Brandon-Valley/BLDC-PCB/BLDC_BOM_mouser.csv

Qty1 | Mfr Part No.
2 | WSLP27261L000FEA
1 | STM32F405RGT6
