Brandon-Valley/BLDC-PCB/BLDC.brd

## EAGLE design BLDC.brd (2017-07-13)

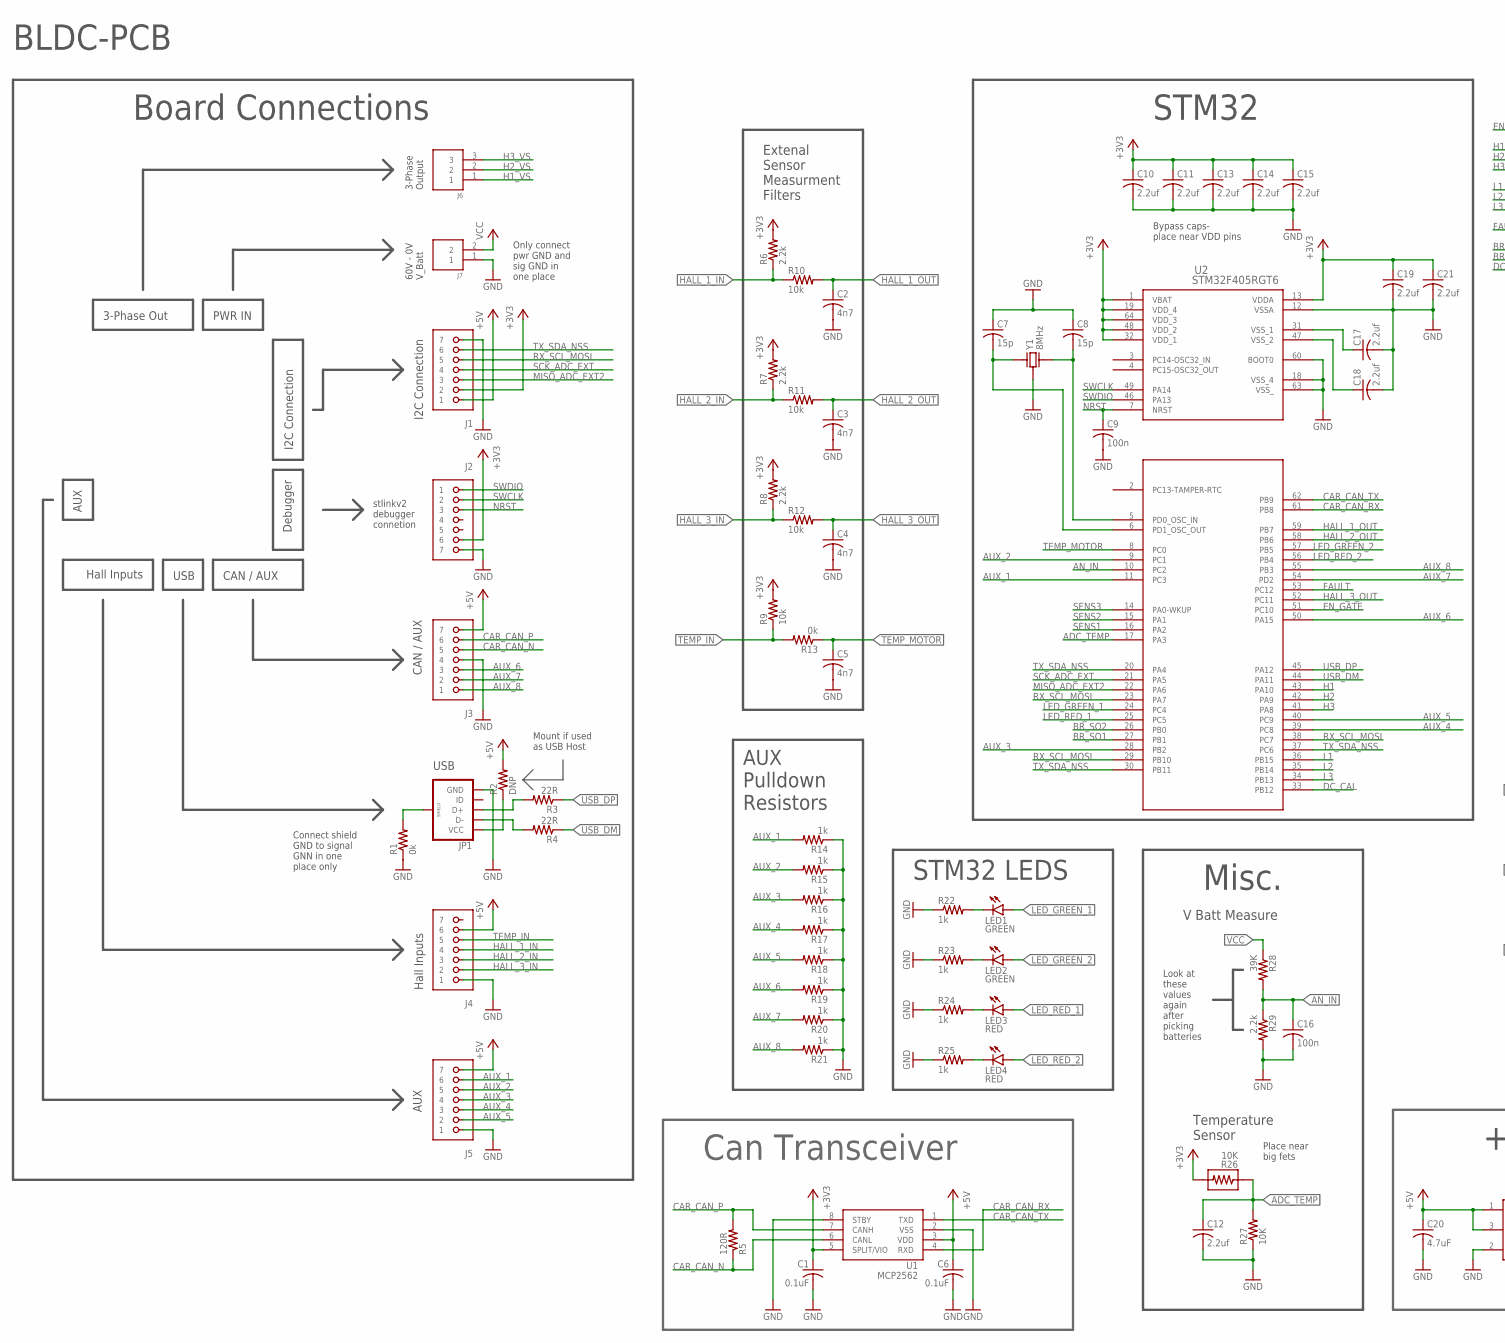
[picture p1: schematic BLDC.sch, part in row 1, column 1]

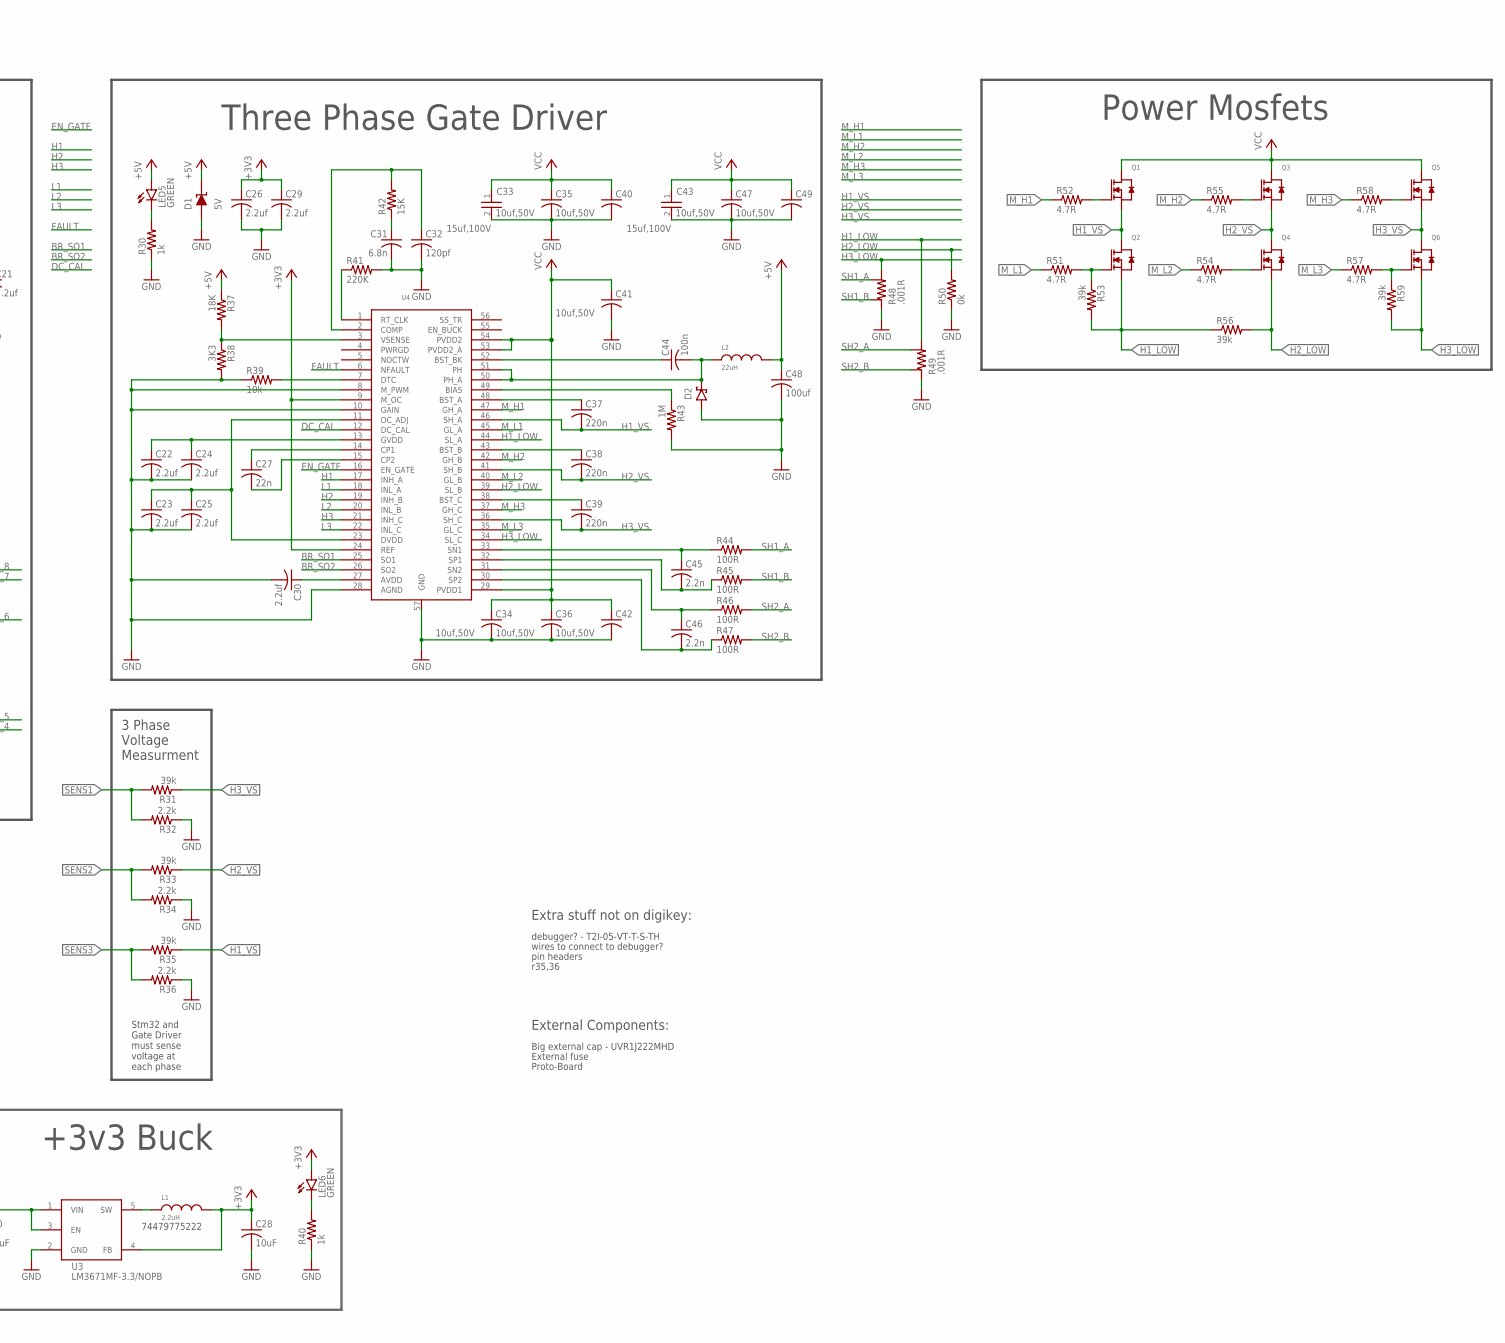
[picture p2: schematic BLDC.sch, part in row 1, column 2]

Parts:
C1, C6: 0.1uF; C0805; PARTNO GRM21BR71E104KA01L
C2, C3, C4, C5: 4n7; C0805; PARTNO GRM2165C1H472FA01D
C7, C8: 15p; C0805; PARTNO CL21C150JBANNNC
C9, C16, C44: 100n; C0805; PARTNO 08053C104KAT2A
C10, C11, C12, C13, C14, C15, C17, C18, C19, C21, C22, C23, C24, C25, C26, C29, C30: 2.2uf; C0805; PARTNO UMK212BB7225KG-T
C20: 4.7uF; C0805; PARTNO GRM21BC81E475KA12L
C27: 22n; C0805; PARTNO C2012C0G1H223J125AA
C28: 10uF; C0805; PARTNO GRM21BR61E106KA73L
C31: 6.8n; C0805; PARTNO C0805C682K5RACTU
C32: 120pf; C0805; PARTNO 08051A121FAT2A
C33, C43: 15uf,100V; K-55; PARTNO KCM55WR72A156MH01K
C34, C35, C36, C40, C41, C42, C47, C49: 10uf,50V; C1206; PARTNO C3216JB1H106K160AB
C37, C38, C39: 220n; C0805; PARTNO GRM219R71C224KA01D
C45, C46: 2.2n; C0805; PARTNO C2012C0G1H222J060AA
C48: 100uf; C0805; PARTNO GRM21BR60G107ME15L
D1: 5V; SOT-23_DIODE; PARTNO SMF5.0A
D2: CD1206-B260; 1206-DIODE; PARTNO CD1206-B260
J1, J2, J3, J4, J5: JST-1X7-MICRO; JST-1X7
J6: IPBT-103-H1-XX-S-RA
J7: IPBT-102-H1-XX-S-RA
JP1: USB_MICROB_PLUG-PTH3; MOLEX-MICROUSB-B-105017-0001
L1: 2.2uH; 0805; PARTNO 74479775222
L2: 22uH; TYS5040220M-10; PARTNO TYS5040220M-10
LED1, LED2, LED5, LED6: GREEN; CHIP-LED0805; PARTNO 598-8170-107F
LED3, LED4: RED; CHIP-LED0805; PARTNO 5988110107F
Q1, Q2, Q3, Q4, Q5, Q6: IRFS7530TRLPBF; D2PAK; PARTNO IRFS7530TRLPBF
R1, R13, R50: 0k; R0805; PARTNO ERJ-6GEY0R00V
R2: DNP; R0805; PARTNO ERJ-6GEY0R00V
R3, R4: 22R; R0805; PARTNO RMCF0805FT22R0
R5: 120R; R0805; PARTNO ERJ-6ENF1200V
R6, R7, R8, R29, R32, R34, R36: 2.2k; R0805; PARTNO ERJ-6ENF2201V
R9, R10, R11, R12, R39: 10k; R0805; PARTNO ERJ-6ENF1002V
R14, R15, R16, R17, R18, R19, R20, R21, R22, R23, R24, R25, R30, R40: 1k; R0805; PARTNO ERJ-6ENF1001V
R26: 10K; 0603; PARTNO NCP18XH103F03RB
R27: 10K; R0805; PARTNO ERJ-6ENF1002V
R28: 39K; R0805; PARTNO ERJ-6ENF3902V
R31, R33, R35, R53, R56, R59: 39k; R0805; PARTNO ERJ-6ENF3902V
R37: 18K; R0805; PARTNO ERJ-6ENF1802V
R38: 3K3; R0805; PARTNO ERJ-6ENF3301V
R41: 220K; R0805; PARTNO ERJ-6ENF2203V
R42: 15K; R0805; PARTNO ERJ-6ENF1502V
R43: 1M; R0805; PARTNO ERJ-3EKF1004V
R44, R45, R46, R47: 100R; R0805; PARTNO ERJ-6ENF1000V
R48, R49: .001R; 2726
R51, R52, R54, R55, R57, R58: 4.7R; R0805; PARTNO ERJ-6RQF4R7V
U1: MCP2562; SOIC8-N_MC; PARTNO MCP2562FD-E/SN
U2: STM32F405RGT6; LQFP-64
U3: LM3671MF-3.3/NOPB; SOT23-5; PARTNO LM3671MF-3.3/NOPB
U4: DRV8302; HTSSOP-56; PARTNO DRV8302DCA
Y1: 8MHz; 4-SMD; PARTNO ABM3B-8.000MHZ-10-1-U-T

Connections:
+3V3: C1.1, C10.1, C11.1, C13.1, C14.1, C15.1, C19.1, C21.1, C26.1, C28.1, C29.1, J1.P$2 (2), J2.P$6 (6), L1.2, LED6.A, R6.2, R7.2, R8.2, R9.2, R26.2, U1.5 (SPLIT/VIO), U2.1 (VBAT), U2.13 (VDDA), U2.19 (VDD_4), U2.32 (VDD_1), U2.48 (VDD_2), U2.64 (VDD_3), U3.4 (FB), U4.9 (M_OC), U4.24 (REF)
+5V: C6.1, C20.1, C48.1, D1.K (CATHODE), J1.P$1 (1), J3.P$7 (7), J4.P$6 (6), J5.P$7 (7), L2.P$2, LED5.A, R2.2, R37.1, U1.3 (VDD), U3.1 (VIN), U3.3 (EN)
ADC_TEMP: C12.1, R26.1, R27.2, U2.17 (PA3)
AN_IN: C16.1, R28.2, R29.1, U2.10 (PC2)
AUX_1: J5.P$6 (6), R14.2, U2.11 (PC3)
AUX_2: J5.P$5 (5), R15.2, U2.9 (PC1)
AUX_3: J5.P$4 (4), R16.2, U2.28 (PB2)
AUX_4: J5.P$3 (3), R17.2, U2.39 (PC8)
AUX_5: J5.P$2 (2), R18.2, U2.40 (PC9)
AUX_6: J3.P$3 (3), R19.2, U2.50 (PA15)
AUX_7: J3.P$2 (2), R20.2, U2.54 (PD2)
AUX_8: J3.P$1 (1), R21.2, U2.55 (PB3)
BR_SO1: U2.27 (PB1), U4.25 (SO1)
BR_SO2: U2.26 (PB0), U4.26 (SO2)
CAR_CAN_N: J3.P$5 (5), R5.1, U1.6 (CANL)
CAR_CAN_P: J3.P$6 (6), R5.2, U1.7 (CANH)
CAR_CAN_RX: U1.4 (RXD), U2.61 (PB8)
CAR_CAN_TX: U1.1 (TXD), U2.62 (PB9)
DC_CAL: U2.33 (PB12), U4.12 (DC_CAL)
EN_GATE: U2.51 (PC10), U4.16 (EN_GATE)
FAULT: U2.53 (PC12), U4.6 (NFAULT)
GND: C1.2, C2.2, C3.2, C4.2, C5.2, C6.2, C7.1, C8.1, C9.2, C10.2, C11.2, C12.2, C13.2, C14.2, C15.2, C16.2, C17.2, C18.2, C19.2, C20.2, C21.2, C22.2, C23.2, C24.2, C25.2, C26.2, C28.2, C29.2, C30.2, C31.2, C32.2, C33.2 (-), C34.2, C35.2, C36.2, C40.2, C41.2, C42.2, C43.2 (-), C47.2, C48.2, C49.2, D1.A (ANODE), D2.A, J1.P$7 (7), J2.P$7 (7), J3.P$4 (4), J4.P$1 (1), J5.P$1 (1), J7.1, JP1.5 (GND), JP1.P$5 (GND), R1.1, R14.1, R15.1, R16.1, R17.1, R18.1, R19.1, R20.1, R21.1, R22.1, R23.1, R24.1, R25.1, R27.1, R29.2, R30.1, R32.1, R34.1, R36.1, R38.2, R39.1, R40.1, R41.2, R43.2, R48.BL (1), R49.BL (1), R50.1, U1.2 (VSS), U1.8 (STBY), U2.12 (VSSA), U2.18 (VSS_4), U2.60 (BOOT0), U2.63 (VSS_), U3.2 (GND), U4.8 (M_PWM), U4.10 (GAIN), U4.28 (AGND), U4.57 (GND), Y1.2 (GND), Y1.4 (GND)
H1: U2.43 (PA10), U4.17 (INH_A)
H1_LOW: Q2.A2 (S), R49.BR (2), R53.2, R56.1, U4.44 (SL_A)
H1_VS: C37.2, J6.1, Q1.A2 (S), Q2.K (D), R35.1, U4.46 (SH_A)
H2: U2.42 (PA9), U4.19 (INH_B)
H2_LOW: Q4.A2 (S), R50.2, R56.2, U4.39 (SL_B)
H2_VS: C38.2, J6.2, Q3.A2 (S), Q4.K (D), R33.1, U4.41 (SH_B)
H3: U2.41 (PA8), U4.21 (INH_C)
H3_LOW: Q6.A2 (S), R48.BR (2), R59.2, U4.34 (SL_C)
H3_VS: C39.2, J6.3, Q5.A2 (S), Q6.K (D), R31.1, U4.36 (SH_C)
HALL_1_IN: J4.P$4 (4), R6.1, R10.1
HALL_1_OUT: C2.1, R10.2, U2.59 (PB7)
HALL_2_IN: J4.P$3 (3), R7.1, R11.1
HALL_2_OUT: C3.1, R11.2, U2.58 (PB6)
HALL_3_IN: J4.P$2 (2), R8.1, R12.1
HALL_3_OUT: C4.1, R12.2, U2.52 (PC11)
L1: U2.36 (PB15), U4.18 (INL_A)
L2: U2.35 (PB14), U4.20 (INL_B)
L3: U2.34 (PB13), U4.22 (INL_C)
LED_GREEN_1: LED1.A, U2.24 (PC4)
LED_GREEN_2: LED2.A, U2.57 (PB5)
LED_RED_1: LED3.A, U2.25 (PC5)
LED_RED_2: LED4.A, U2.56 (PB4)
MISO_ADC_EXT2: J1.P$3 (3), U2.22 (PA6)
M_H1: R52.1, U4.47 (GH_A)
M_H2: R55.1, U4.42 (GH_B)
M_H3: R58.1, U4.37 (GH_C)
M_L1: R51.1, U4.45 (GL_A)
M_L2: R54.1, U4.40 (GL_B)
M_L3: R57.1, U4.35 (GL_C)
unnamed: LED3.C, R24.2
unnamed: LED2.C, R23.2
unnamed: JP1.2 (D-), JP1.P$2 (D-), R4.2
unnamed: JP1.3 (D+), JP1.P$3 (D+), R3.2
unnamed: JP1.1 (VCC), JP1.P$1 (VCC), R2.1
unnamed: C18.1, U2.47 (VSS_2)
unnamed: C8.2, U2.5 (PD0_OSC_IN), Y1.3
unnamed: C7.2, U2.6 (PD1_OSC_OUT), Y1.1
unnamed: R41.1, U4.1 (RT_CLK)
unnamed: C31.1, R42.1
unnamed: L1.1, U3.5 (SW)
unnamed: C32.1, R42.2, U4.2 (COMP)
unnamed: R37.2, R38.1, U4.3 (VSENSE)
unnamed: R39.2, U4.7 (DTC)
unnamed: C23.1, C25.1, U4.11 (OC_ADJ), U4.23 (DVDD)
unnamed: C22.1, C24.1, U4.13 (GVDD)
unnamed: C27.1, U4.14 (CP1)
unnamed: C30.1, U4.27 (AVDD)
unnamed: C27.2, U4.15 (CP2)
unnamed: C44.1, U4.52 (BST_BK)
unnamed: C44.2, D2.C (K), L2.P$1, U4.50 (PH_A), U4.51 (PH)
unnamed: R43.1, U4.49 (BIAS)
unnamed: C37.1, U4.48 (BST_A)
unnamed: C45.1, R44.1, U4.33 (SN1)
unnamed: C38.1, U4.43 (BST_B)
unnamed: C45.2, R45.1, U4.32 (SP1)
unnamed: C39.1, U4.38 (BST_C)
unnamed: C46.2, R47.1, U4.30 (SP2)
unnamed: C46.1, R46.1, U4.31 (SN2)
unnamed: Q1.A1 (G), R52.2
unnamed: Q3.A1 (G), R55.2
unnamed: Q5.A1 (G), R58.2
unnamed: Q2.A1 (G), R51.2, R53.1
unnamed: Q4.A1 (G), R54.2
unnamed: Q6.A1 (G), R57.2, R59.1
unnamed: C17.1, U2.31 (VSS_1)
unnamed: LED1.C, R22.2
unnamed: LED4.C, R25.2
unnamed: LED5.C, R30.2
unnamed: LED6.C, R40.2
NRST: C9.1, J2.P$3 (3), U2.7 (NRST)
RX_SCL_MOSI: J1.P$5 (5), U2.23 (PA7), U2.29 (PB10), U2.38 (PC7)
SCK_ADC_EXT: J1.P$4 (4), U2.21 (PA5)
SENS1: R31.2, R32.2, U2.16 (PA2)
SENS2: R33.2, R34.2, U2.15 (PA1)
SENS3: R35.2, R36.2, U2.14 (PA0-WKUP)
SGND: JP1.P$6 (SHIELD), JP1.P$7 (SHIELD), JP1.P$8 (SHIELD), JP1.P$9 (SHIELD), R1.2
SH1_A: R44.2, R48.TR (22)
SH1_B: R45.2, R48.TL (12)
SH2_A: R46.2, R49.TR (22)
SH2_B: R47.2, R49.TL (12)
SWCLK: J2.P$2 (2), U2.49 (PA14)
SWDIO: J2.P$1 (1), U2.46 (PA13)
TEMP_IN: J4.P$5 (5), R9.1, R13.2
TEMP_MOTOR: C5.1, R13.1, U2.8 (PC0)
TX_SDA_NSS: J1.P$6 (6), U2.20 (PA4), U2.30 (PB11), U2.37 (PC6)
USB_DM: R4.1, U2.44 (PA11)
USB_DP: R3.1, U2.45 (PA12)
VCC: C33.1 (+), C34.1, C35.1, C36.1, C40.1, C41.1, C42.1, C43.1 (+), C47.1, C49.1, J7.2, Q1.K (D), Q3.K (D), Q5.K (D), R28.1, U4.29 (PVDD1), U4.53 (PVDD2_A), U4.54 (PVDD2)

Notes on the sheet:
+3v3 Buck
74479775222
Bypass caps- place near VDD pins
Can Transceiver
BLDC-PCB
Mount if used as USB Host
Look at these values again after picking batteries
STM32
Stm32 and Gate Driver must sense voltage at each phase
Three Phase Gate Driver
Power Mosfets
stlinkv2 debugger connetion
Extra stuff not on digikey:
wires to connect to debugger?
pin headers
Connect shield GND to signal GNN in one place only
60V - 0V V_Batt
r35,36
debugger? - T2I-05-VT-T-S-TH
AUX Pulldown Resistors
STM32 LEDS
I2C Connection
CAN / AUX
AUX
USB
Debugger
Hall Inputs
PWR IN
3-Phase Out
Place near big fets
Big external cap - UVR1J222MHD
3-Phase Output
Board Connections
Temperature Sensor
V Batt Measure
Extenal Sensor Measurment Filters
3 Phase Voltage Measurment
Only connect pwr GND and sig GND in one place
Misc.
External fuse
External Components:
Proto-Board

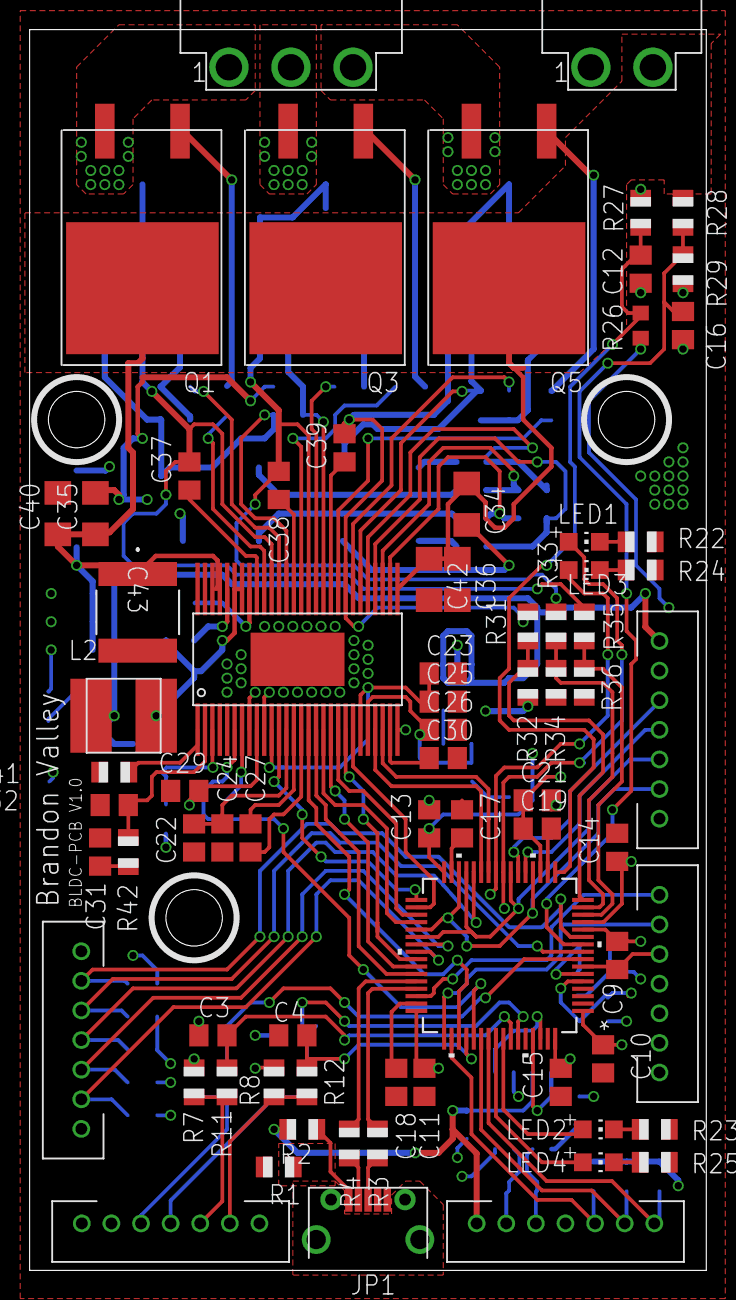
[picture p3: board BLDC.brd from above]

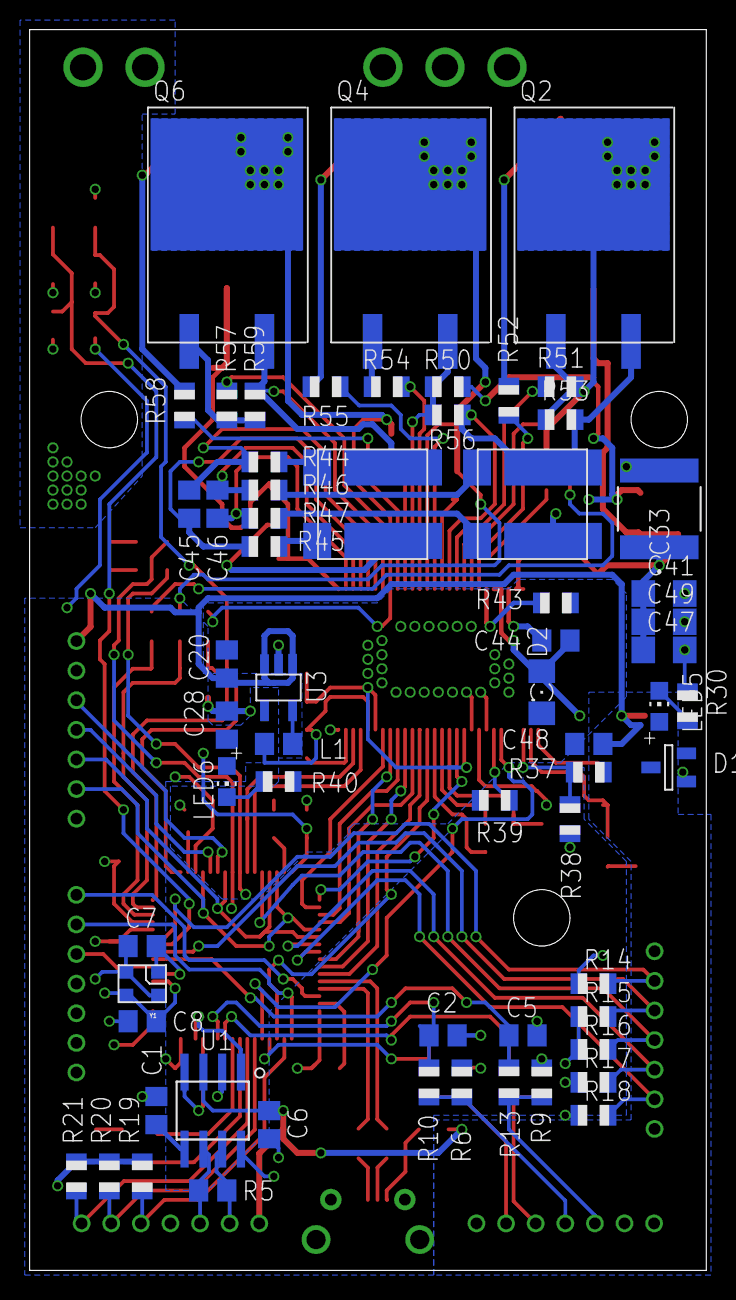
[picture p4: board BLDC.brd from below]

Board: 2 copper layers, 45.7 x 83.8 mm, 137 parts (62 on the bottom side), 110 nets.
