Brandon-Valley/BLDC-PCB/(commit log)

2017-02-07 added minor systems and some stm32 connections
    [BLDC.sch]
2017-02-15 added DRV8302
    [BLDC.sch]
2017-02-15 Added gate driver connections
    [BLDC.sch]
2017-02-16 added power fets
    [BLDC.sch]
2017-02-17 added debugger
    [BLDC.sch]
2017-02-17 added CAN connection
    [BLDC.sch]
2017-02-17 created brd
    [BLDC.brd]
2017-02-18 Added usb shielding
    [BLDC.brd, BLDC.sch]
2017-02-23 added shunts, changed H1_low to GND, and deleted brd
    [BLDC.brd, BLDC.sch]
2017-02-24 added DC-DC Converter
    [BLDC.sch]
2017-02-27 Merge remote-tracking branch 'refs/remotes/origin/master'
    Conflicts:
    BLDC.brd
    BLDC.sch
    [BLDC.sch]
2017-02-27 Merge remote-tracking branch 'refs/remotes/origin/master' - also added usb shield
    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
    [BLDC.sch]
2017-03-01 added some inputs
    [BLDC.sch]
2017-03-01 Added note about dc-dc converter
    [BLDC.sch]
2017-03-01 added dummy aux inputs
    [BLDC.sch]
2017-03-01 added brd temp and motor temp
    [BLDC.sch]
2017-03-01 cleaned up sch a bit
    [BLDC.sch]
2017-03-01 cleaned up sch and added outputs
    [BLDC.sch]
2017-03-02 added pin headeders and 60V shtky diode
    [BLDC.sch]
2017-03-02 connected inputs
    [BLDC.sch]
2017-03-02 Deleted DC-DC Converter
    [BLDC.sch]
2017-03-03 coinnected dummy aux
    [BLDC.sch]
2017-03-05 org brd modules
    [BLDC.brd, BLDC.sch]
2017-03-05 renumbered parts
    [BLDC.brd, BLDC.sch]
2017-03-05 gate driver module progress
    [BLDC.brd]
2017-03-05 updated BOM
    [BLDC.brd, BLDC.sch]
2017-03-07 consdensed gate driver module
    [BLDC.brd]
2017-03-08 stm32 module progress
    [BLDC.brd, BLDC.sch]
2017-03-15 added connector note
    [BLDC.sch]
2017-03-16 minor stm32 sch change
    [BLDC.brd, BLDC.sch]
2017-03-21 2x2 layout org
    [BLDC.brd]
2017-03-24 added holes
    [BLDC.brd, BLDC.sch]
2017-03-24 +3V3 voltage regulator module done
    [BLDC.brd]
2017-03-27 added aux pulldowns
    [BLDC.brd, BLDC.sch]
2017-03-27 Added jst connectors
    [BLDC.brd, BLDC.sch]
2017-04-18 added stm32 LEDs
    [BLDC.brd, BLDC.sch]
2017-04-20 only 8 aux now
    [BLDC.brd, BLDC.sch]
2017-04-20 about to change fet driver module
    [BLDC.brd]
2017-04-20 changed via diameters
    [BLDC.brd, DRILEGEND.CFG]
2017-04-20 commited to micro JST connectors
    [BLDC.brd, BLDC.sch]
2017-06-08 figured out rough layout of connectors
    [BLDC.brd]
2017-06-09 made very rough boarder dimentions and hole placement
    [BLDC.brd, BLDC.sch]
2017-06-10 placed usb connect
    [BLDC.brd, BLDC.sch]
2017-06-10 rough layout of all component groups done
    [BLDC.brd, BLDC.sch]
2017-06-11 final board dimentions defined
    [BLDC.brd, BLDC.sch]
2017-06-30 added jumper so H2_LOW doesn't connect directly to GND b/c Im paranoid
    [BLDC.brd, BLDC.sch]
2017-07-01 about to start messing with files
    [BLDC.brd]
2017-07-02 switched GND and VCC, also a lot of layout progress
    [BLDC.brd, BLDC.sch]
2017-07-02 Just made GND plane, about to start fixing bad connections
    [BLDC.brd]
2017-07-02 layout progress, about to start cleaning up airwires
    [BLDC.brd, BLDC.sch]
2017-07-02 airwires cleaned up
    [BLDC.brd]
2017-07-03 fixed all errors - 1st pass
    [BLDC.brd, BLDC.sch]
2017-07-03 added +5V LED
    [BLDC.brd]
2017-07-03 cleaned brd up a bit
    [BLDC.brd]
2017-07-03 cleaned up some files
    [BLDC.sch]
2017-07-04 moved silks around
    [BLDC.sch]
2017-07-04 added name and title
    [BLDC.sch]
2017-07-04 deleted t-place names
    [BLDC.brd]
2017-07-04 fixed some tiny errors
    [BLDC.sch]
2017-07-05 added big inductor and updated BOM a bit
    [BLDC.brd]
2017-07-05 added some large components at the last minute because I am a glutton for punishment
    [BLDC.brd, BLDC.sch]
2017-07-06 added jumper for DNP on usb
    [BLDC.brd]
2017-07-06 fixed brd errors
    [BLDC.brd]
2017-07-06 made brd look all pretty
    [BLDC.brd]
2017-07-06 added v1.0 onto brd name
    [BLDC.brd]
2017-07-06 generated CAMS and cleaned up files
    [BLDC_BottomCopper.GBL, BLDC_BottomMask.GBS, BLDC_BottomSilkS.GBO, BLDC_Drill.XLN, BLDC_Outline.GKO, BLDC_TopCopper.GTL, BLDC_TopMask.GTS, BLDC_TopSilkS.GTO]
2017-07-13 added mouser bom
    [BLDC.csv, BLDC_BOM_mouser.csv, BLDC_OrderUploadMouser.csv]
2017-07-13 got rid of names
    [BLDC.brd]
2017-07-13 cleaned up files
    [BLDC_OrderUploadMouser.csv]
2017-07-13 cleaned up 2 ERC errors
    [BLDC.sch]
2017-09-04 Y1 wrong package
    [BLDC_BOM_mouser.csv]
