Brandon-Valley/BLDC-PCB/(notices)

Notices in the files:
parts and their libraries:
FormE: COPYRIGHT: Copyright C 2015 Accelerated Designs. All rights reserved
